fablabnk/DaisySeedProjects/Hardware/GuitarPedal1590b_2Layer/pcb/DesignNotes.md

Why is R21 SMD? It's not, it's to allow easy bridging of the pads

There is a 5V isolated power plane on F.Cu

Trace widths:
0,9 power
0,25 signal

VIN
+3.3V
+9V
+5V
