fablabnk/DaisySeedProjects/Hardware/GuitarPedal1590b_2Layer/docs/Bill_of_Materials_BOM.xlsx

Item # | *Designator | *Qty | Manufacturer | *Mfg Part # | Description / Value | *Package/Footprint | Type | Your Instructions / Notes | Have
1 | A1 | 1 | Electro-Smith | https://www.electro-smith.com/daisy/daisy | Daisy Seed | 20 Pin Headers | thru-hole | Use two 20pin female headers to make a socket for the Seed. This is needed since some components fit under the seed. I used these: https://www.amazon.com/dp/B09MYBZZKZ | Y
2 | C1, C4, C5, C9, C10, C11, C12, C15, C16 | 9 | Generic | Generic | Ceramic Capacitor 10uF | Disc | thru-hole |  | Y
3 | C2, C3, C7, C8, C13, C14 | 6 | WIMA | MKS2C031001A00JC00 | Film Capacitor 100nF | Box | thru-hole | https://www.mouser.com/ProductDetail/505-MKS2C031001AJC00 | Y
4 | C17 | 1 | Generic | Generic | Ceramic Capacitor 100nF | Disc | thru-hole |  | Y
4 | C6 | 1 | Generic | Generic | Electrolytic Capacitor 22uF | Radial | thru-hole |  | Y OMIT
5 | D1 | 1 | Generic | Generic | Diode 1N5817 | SOD27 | thru-hole |  | Y
6 | D2 | 1 | Generic | Generic | Diode 1N4148 or Diode 1N914 | SOD27 | thru-hole |  | Y
7 | FS1, FS2 | 2 | DaierTek | ASIN: B08TBTWDYV | SPST Momentary Soft Touch Foot Switch | Panel Mount | thru-hole | Connect circuit board pads to foot switch leads with 22 AWG wire so the footswitch can be mounted on the enclosure. Used this part: https://www.amazon.com/dp/B08TBTWDYV | N | https://www.aliexpress.com/item/1005004646906063.html
8 | J1 | 1 | Gravitech (https://www.mouser.com/manufacturer/gravitech/) | CON-SOCJ-2155 | 2.1mm DC Power Jack | PCB Mount | thru-hole | https://www.mouser.com/ProductDetail/992-CON-SOCJ-2155 | N | https://www.aliexpress.com/item/1005003324016159.html
9 | J2, J3 | 2 | DaierTek | ASIN: B097BDHV5Y | 1/4" Jack Female 6.35mm Stereo Socket PCB Mount | 6 pin | thru-hole | https://www.amazon.com/dp/B097BDHV5Y | N | https://www.aliexpress.com/item/1005004458769152.html
10 | J4, J5 | 2 | uxcell | ASIN: B07KY8NMD5 | 3.5mm Audio Jack Connector PCB Mount Female Socket | 4-Pin PJ-320A | thru-hole | https://www.amazon.com/dp/B07KY8NMD5 | N | https://www.aliexpress.com/item/1005003111662179.html
11 | L1 | 1 | Generic | Generic | 2.2uH Inductor Iron Core | Radial | thru-hole |  | N OMIT | https://www.aliexpress.com/item/1005003111990185.html
12 | LED1, LED2 | 2 | Generic | Generic | 3mm LED | Panel Mount | thru-hole | Connect circuit board pads to LED with 22 AWG wire so that the led can be mounted on the enclosure. Any led should work, there is a 1k resistor to limit the current from the 3.3v source. I used these nice LED holders to mount on the enclosure: https://www.amazon.com/dp/B083Q9QMN4 | Y
13 | POT1, POT2, POT3, POT4 | 4 | Generic | Generic | 10k Potentiameter Linear Taper (Type B) Long Pins | Panel Mount | thru-hole | I used pots with long leads from Tayda. They worked great. https://www.taydaelectronics.com/potentiometer-variable-resistors/rotary-potentiometer/linear/tayda-10k-ohm-linear-taper-potentiometer-spline-shaft-pcb-mount-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 or you can connect circuit board pads to each POT wires for non-long lead pots. | N
14 | R1, R2, R4, R5, R7, R8, R9, R10, R13, R14 | 10 | Generic | Generic | 2M Ohm Resistor Metal Film 1/4W +/-1% | Axial | thru-hole |  | Y
15 | R3, R6 | 2 | Generic | Generic | 100K Ohm Resistor Metal Film 1/4W +/-1% | Axial | thru-hole |  | Y
16 | R11, R12 | 2 | Generic | Generic | 100 Ohm Resistor Metal Film 1/4W +/-1% | Axial | thru-hole |  | Y
17 | R15 | 1 | Generic | Generic | 220 Ohm Resistor Metal Film 1/4W +/-1% | Axial | thru-hole |  | Y
18 | R16 | 1 | Generic | Generic | 33 Ohm Resistor Metal Film 1/4W +/-1% | Axial | thru-hole |  | Y
19 | R17 | 1 | Generic | Generic | 10 Ohm Resistor Metal Film 1/4W +/-1% | Axial | thru-hole |  | Y
20 | R18 | 1 | Generic | Generic | 470 Ohm Resistor Metal Film 1/4W +/-1% | Axial | thru-hole |  | Y
21 | R19, R20 | 2 | Generic | Generic | 1K Ohm Resistor Metal Film 1/4W +/-1% | Axial | thru-hole |  | Y
22 | R21 | 0 | DNP (Do Not Place) |  |  |  |  |  | -
23 | U1 | 1 | STMicorelectronics | L4931CZ50-AP | LDO Voltage Regulators 5.0V 0.25A Positive | TO-92 | thru-hole | https://www.mouser.com/ProductDetail/511-L4931CZ50-AP | N | https://www.aliexpress.com/item/33016868966.html
24 | U2 | 1 | CUI Inc. | PDS1-S5-S5-D | Isolated DC/DC Converter 1W 4.5-5.5Vin 5Vout 200mA unreg iso | Custom Package | thru-hole | https://www.mouser.com/ProductDetail/490-PDS1-S5-S5-D | N OMIT
25 | U3 | 1 | Microchip Technology | MCP6004-I/P | IC OpAmp 4-Circuit | 14-DIP | thru-hole | https://www.digikey.com/en/products/detail/microchip-technology/MCP6004-I-P/523060 | N | https://www.aliexpress.com/item/1005006784520111.html
26 | U4 | 1 | Texas Instruments | OPA2134PA | IC OpAmp 2-Circuit | 8-DIP | thru-hole | https://www.mouser.com/ProductDetail/595-OPA2134PA | N | https://www.aliexpress.com/item/32925731912.html
27 | U5 | 1 | isocom | H11L1 | Optocoupler, 1 Channel, 5kV | 6-DIP | thru-hole | https://www.newark.com/isocom/h11l1/optocoupler-schmitt-trigger-5300vrms/dp/45P3438 | N | https://www.aliexpress.com/item/1005006907441685.html
